Jyrgal/eggPickup/eng1000 motor design 2.docx

Equipment/Parts list for each function

Getting motor to just spin and controlling speed

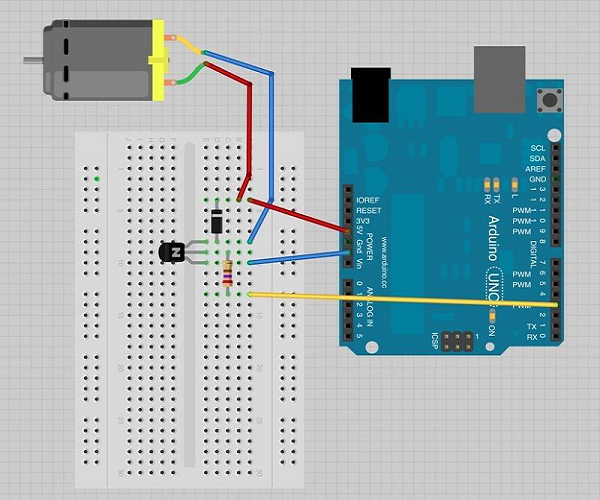
[picture p3: figure]
DC Motor Connections

- PN2222 Transistor
- Small 6V DC motor
- N4001 diode
- 270 ohm resistor

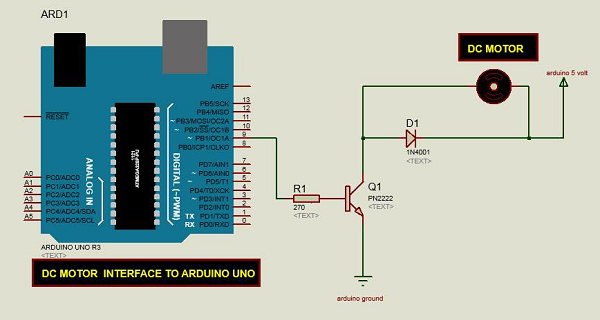
[picture p4: figure]
Motor Speed Control

Controlling direction

- L298 Bridge IC
- Jumper wires

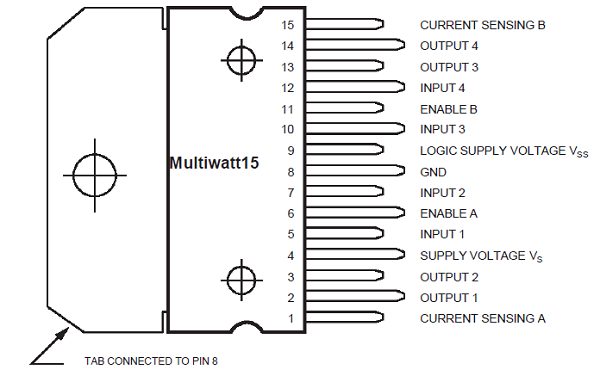
[picture p5: figure]
Spin Direction Control
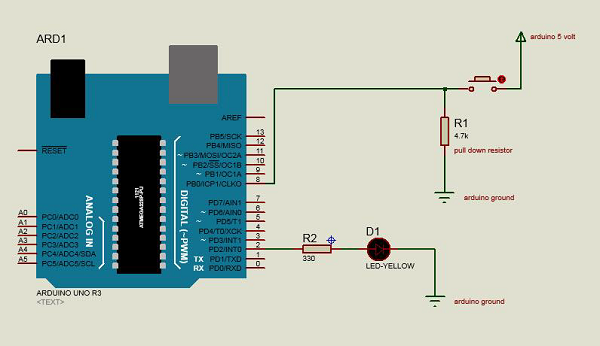
[picture p6: figure]
Spin Direction Control Connections

IN1 | IN2 | FUNCTION
| | BRAKE
1 | | FORWARD
| 1 | BACKWARD
1 | 1 | BRAKE

Code is all done
