Jyrgal/eggPickup/eng1000 circuitry.docx

Servo:

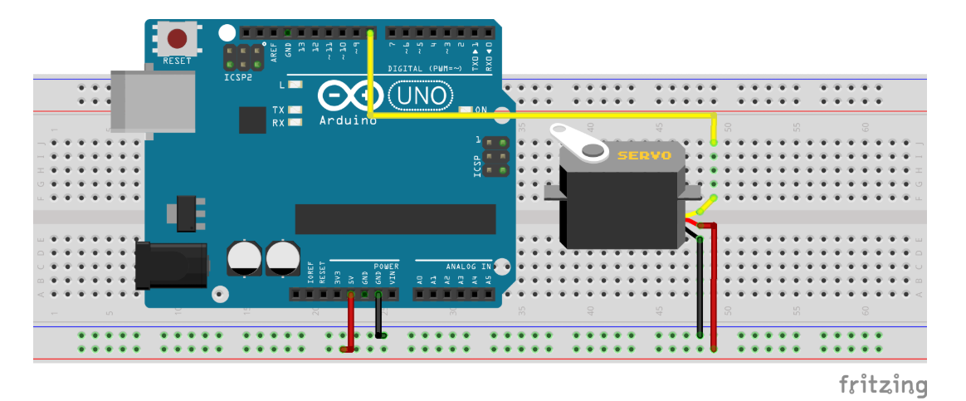
[picture p8: figure]
